catoprovector/Field-Warming-Project/README.md

# Field Warming Setup for Plant Heat Stress
Climate change will dramatically impact the physiology of plants, in both ecological and agricultural contexts. Conducting experiments to elucidate plant responses to heat stress are essential to prepare for and understand the impact of coming climatic changes. Ideal experiments are those wherein plants are exposed to higher temperatures while maintaining as close to natural conditions as possible. Field warming setups are the best experimental analog to future climate change temperatures. In this project, heating cables were combined with Open Top Containers to create a field warming setup that can be used to explore plant response to heat stress.

## Main features
In this project, a field warming setup was constructed consisting of an Open Top Container (basically a clear box with no top) with added heating from heating cables. The purpose of this setup was to investigate how plants, especially snowdrops and Arabidopsis, react to increased temperatures. The field warming setup is different from an indoor growth chamber because it is outside where the plants can be exposed to normal environmental processes.

## Build instructions
Some instructions are presented in `./Docs`

## Outcomes
The test results are presented in `./Docs`

## Team

+ Project lead: Joshua Hauser
+ Contributors:

## Get involved

Comments and suggestions on this folder structure are always welcome. Please create an issue to share your feedback or question, or if you prefer send a pull request. 

## License

CERN-OHL-P-2.0

### (How to cite:)

+ Joshua Hauser, Master Project, 2023

## (Funding)

This project was supported by the Lili's Proto Lab Open Science Hacker program.

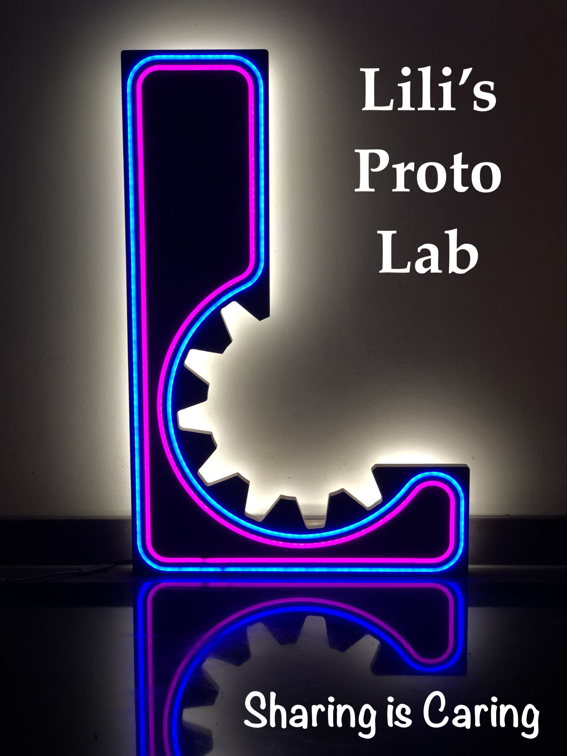
[picture p1: Docs/Images/lpl_sharing.jpg]
LPL sharing image
